framortej/TFG_MySenser-Domoticz/README.md

# TFG_MySenser-Domoticz
Repositorio del TFG "Desarrollo de sistemas domóticos basados en la red MySensor"
