framortej/TFG_MySenser-Domoticz/DOC/(PRESENTACION_V1.2)Desarrollo de sistemas domóticos basados en la red MySensor.pdf

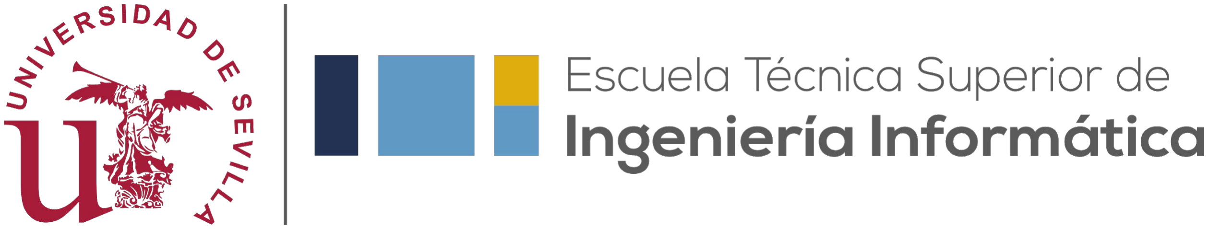
[picture p1: figure]

# Desarrollo de sistemas domóticos basados en la red MySensor

## Alumno: Francisco Moreno Tejeda Tutor: Manuel Jesús Bellido Díaz

# Índice

## ➔ Introducción

## ➔ Planificación

## ➔ Recursos

## ➔ P0 Shield para Raspberry Pi

## ➔ P1 - P2 Gestión eléctrica

## ➔ P3 Control lumínico de tiras LEDs

## ➔ P4 Estación Meteorológica

## ➔ Conclusión y futuro del proyecto

## ➔ Preguntas

# Introducción

### - ¿Qué es la domótica?

- Automatización del hogar
- Llevar el control al mundo digital
- Gestión desde un mismo dispositivo
- Aumentar la seguridad
- Ahorro energético

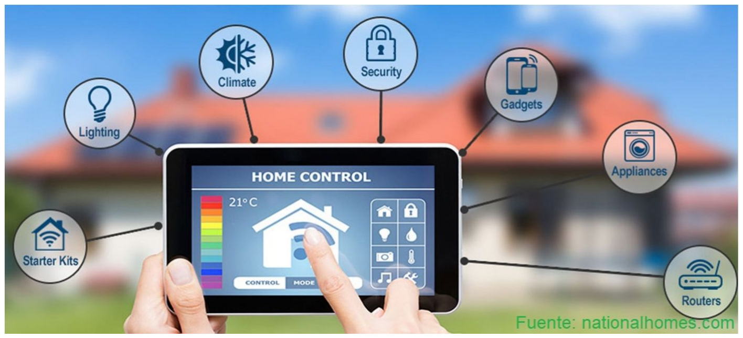
[picture p2: figure]

# Introducción

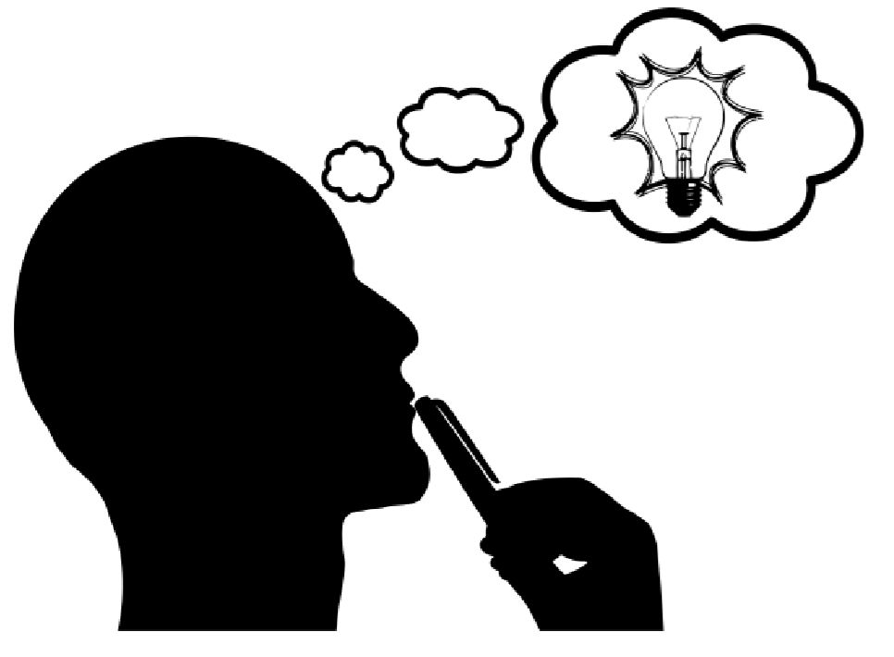
[picture p3: figure]

### - Motivación del TFG

- Ahorro de costes
- Gestión autónoma
- Personalización a medida
- Posibilidades educativas
- Gusto por el tema

# Planificación

### - Objetivos

- Gestionar la energía del hogar
- Gestionar el brillo de una tira led
- Adquisición de datos ambientales

### - Requisitos

- Se debe controlar un enchufe
- Se debe controlar un lámpara
- Se debe gestionar una tira led
- Se debe adquirir datos medioambientales, para, si procede, gestionar los requisitos anteriores.

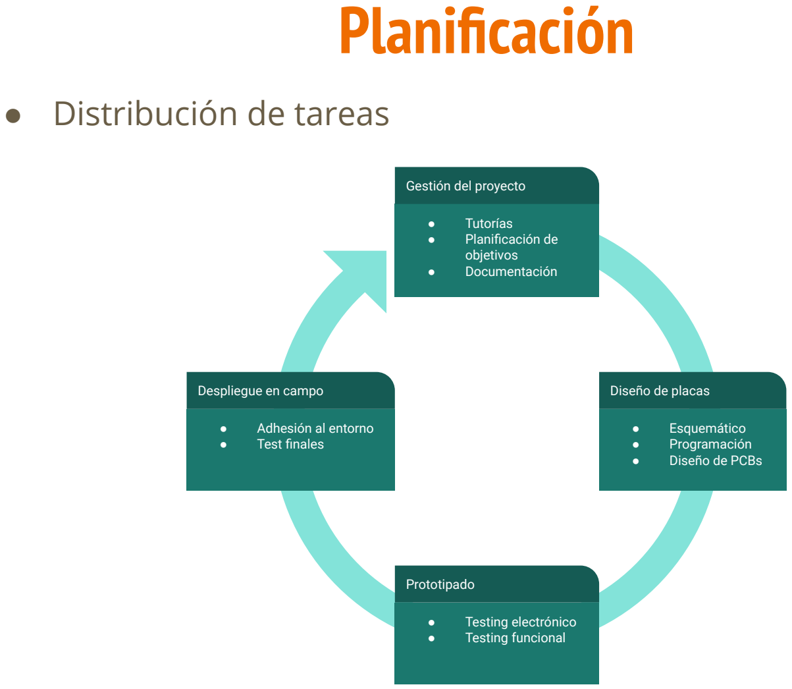
[picture p4: figure]
Planificación; ● Distribución de tareas; ● Esquemático ● Programación ● Diseño de PCBs; Diseño de placas; ● Tutorías ● Planificación de objetivos ● Documentación; Gestión del proyecto; ● Adhesión al entorno ● Test finales; Despliegue en campo; ● Testing electrónico ● Testing funcional; Prototipado

# Planificación

### - Costes

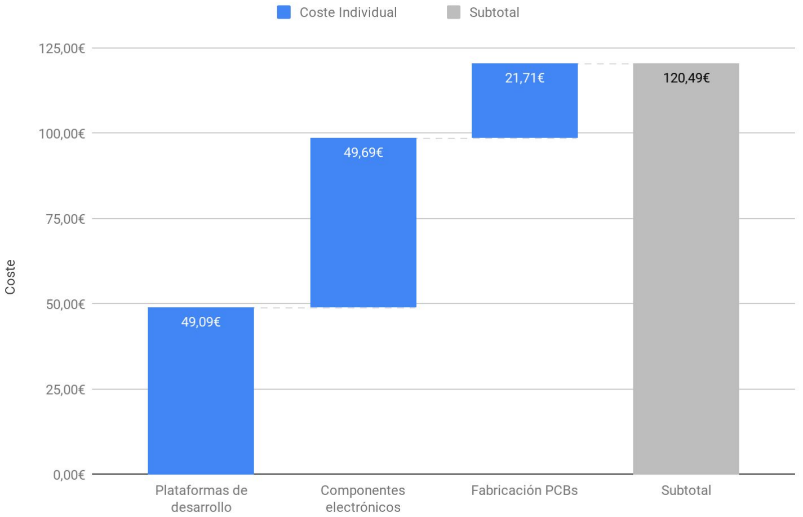
[picture p5: figure]

# Recursos

### - MySensors

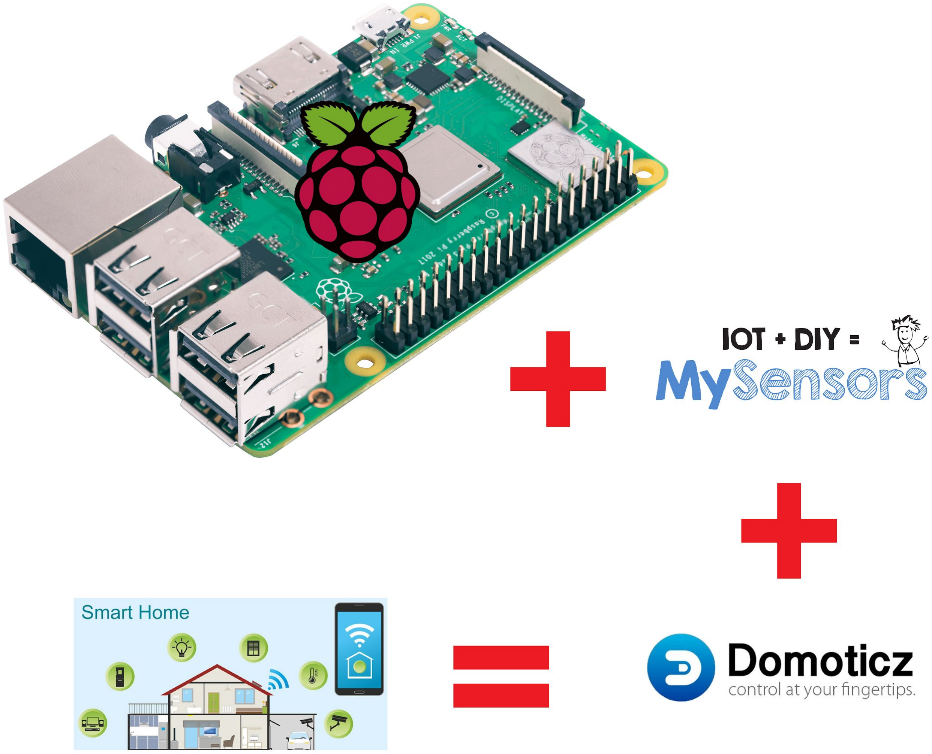
[picture p6: figure]

- Código abierto
- Simplicidad de programación
- Comunidad muy extensa
- Compatibilidad con bastantes controladores

### - Domoticz

- Código abierto
- Multiplataforma
- Gestión de usuarios
- Posibilidad de programación
- Altamente Personalizable
- Aplicación en Android

# Recursos

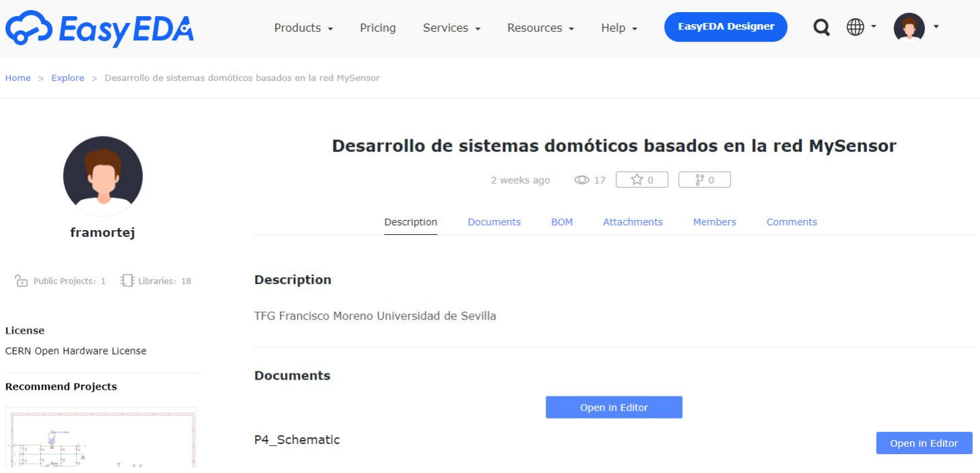
[picture p7: figure]

### - EasyEDA

- Editor gratuito
- Gran comunidad
- Miles de librerías
- Proyectos públicos
- Multiplataforma

### - Arduino IDE

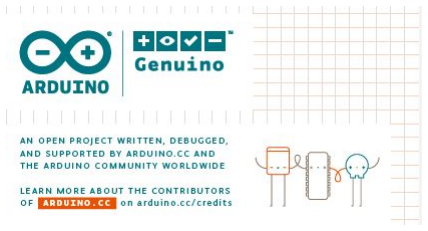
[picture p8: figure]

- Código abierto
- Simplicidad de programación
- Multiplataforma
- Compatibilidad total con las placas
- GitHub
- Plataforma gratuita
- Control de versiones
- Gran comunidad

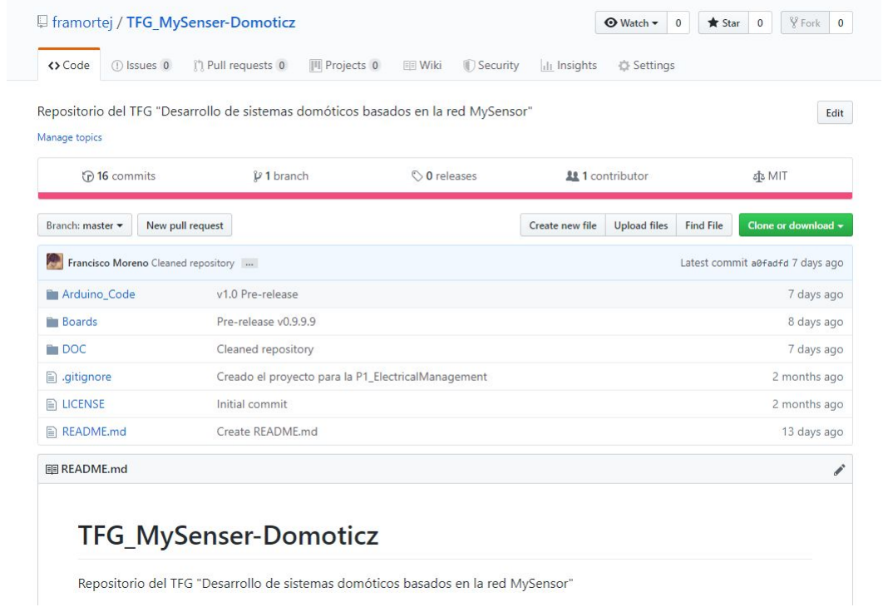
[picture p9: figure]

# P0 Shield para Raspberry Pi

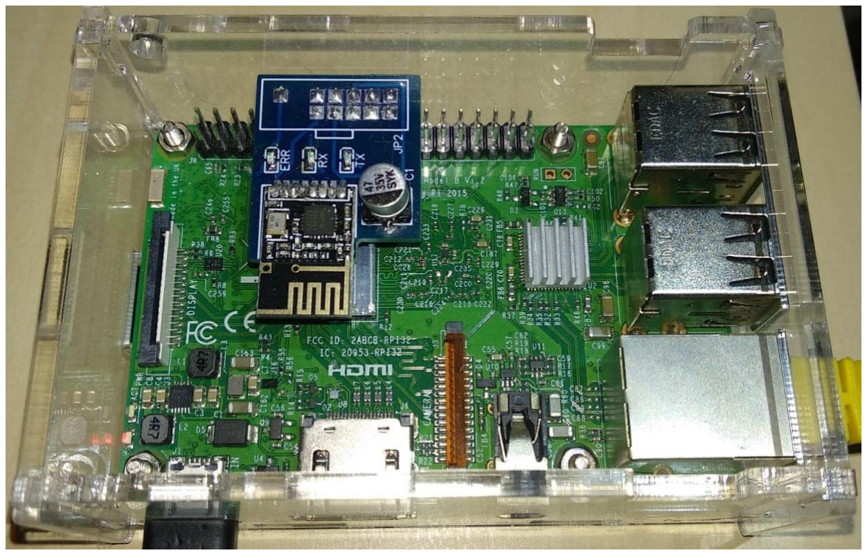
[picture p10: figure]

### - Componentes principales

- nRF24L01+
- 3 LEDs

### - Funcionalidad Principal

- Comunicaciones entre el GW y los nodos
- Indicar el estado del GW
- Mitigar posible errores de comunicación

# P1 - P2 Gestión Eléctrica

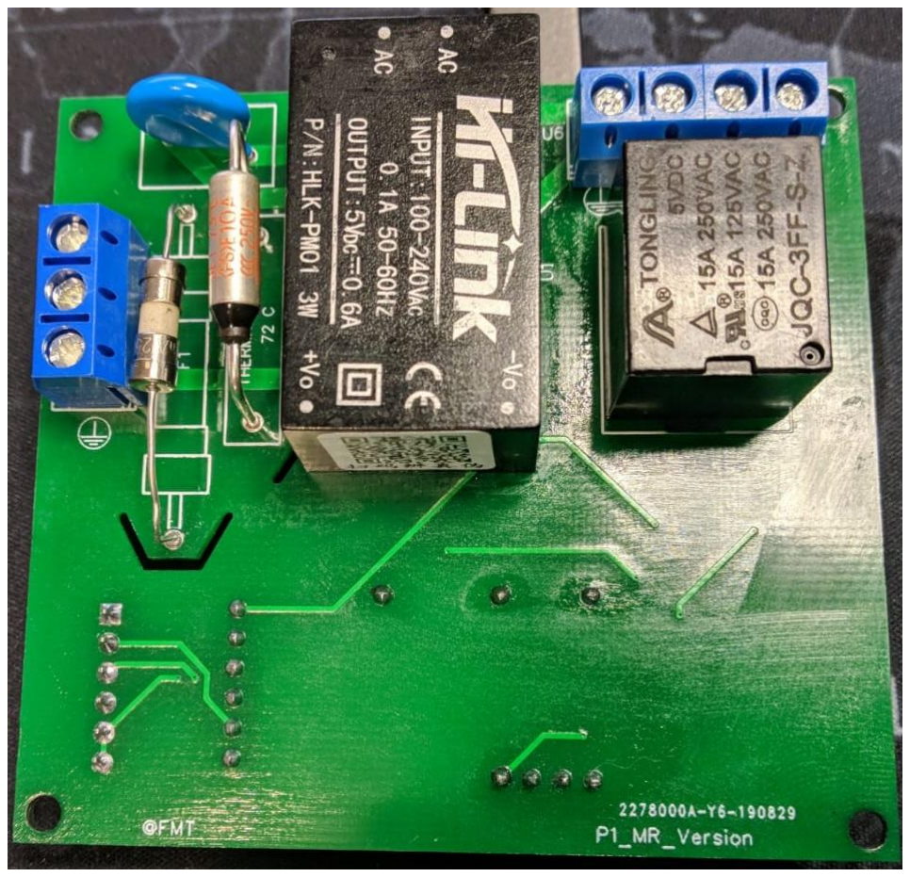
[picture p11: figure]

### - Componentes principales

- nRF24L01+
- Fuente de alimentación 230V-5V
- LED
- Arduino Pro Mini 5V
- Relé
■ Mecánico 15A
■ SSR 2A

### - Funcionalidad Principal

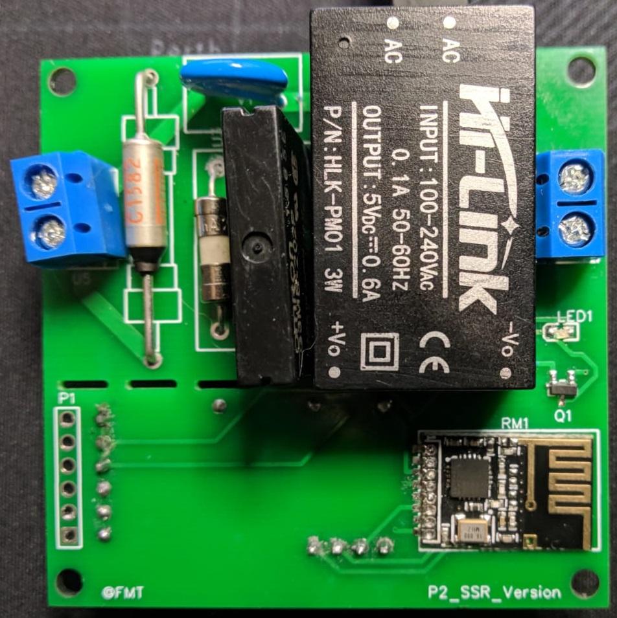
[picture p12: figure]

- Control de la tensión hasta 3450W (15A) ■ Gestión de un enchufe
- Control de la tensión hasta 460W (15A) ■ Gestión de una lámpara

# P3 Control Lumínico USB

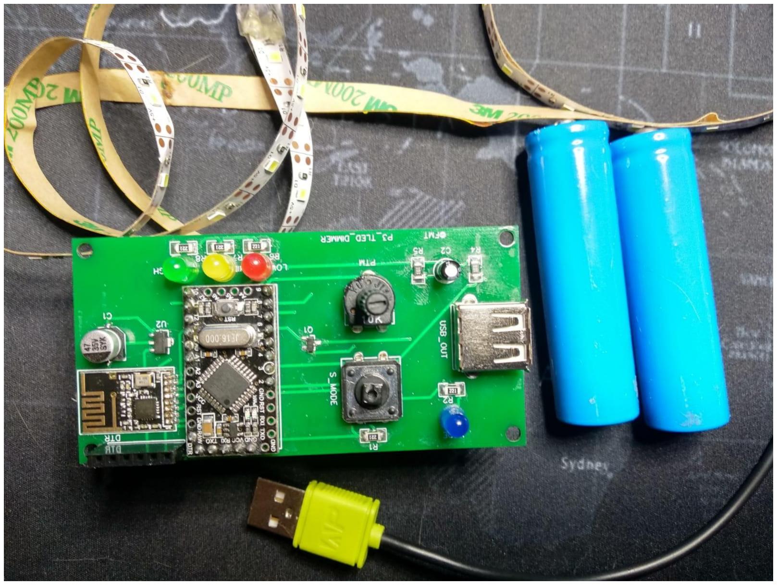
[picture p13: figure]

### - Componentes principales

- nRF24L01+
- Potenciómetro & botón
- 4 LEDs
- Arduino Pro Mini 5V
- 2 Baterías 18650

### - Funcionalidad Principal

- Control del brillo de una tira led de 5V
- Control tanto manual como online

# P4 Estación Meteorológica

### - Componentes principales

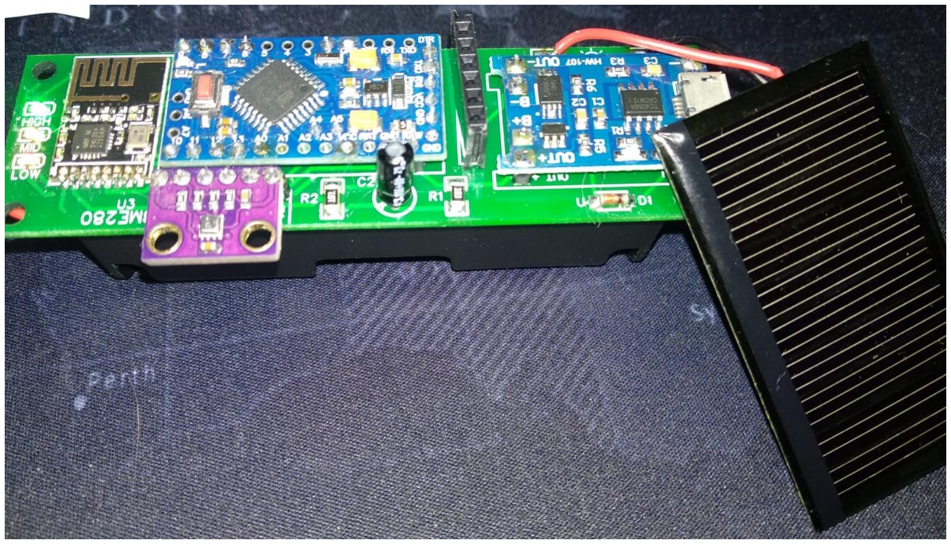
[picture p14: figure]

- nRF24L01+
- 3 LEDs
- Arduino Pro Mini 3.3V
- 1 Baterías 18650
- Sensor BME 280
- Panel solar 5v 30mA
- Gestor de carga TP4056

### - Funcionalidad Principal

- Envío cada 10 m de:
■ Temperatura
■ Humedad
■ Presión Atmosférica

# Conclusión y futuro del proyecto

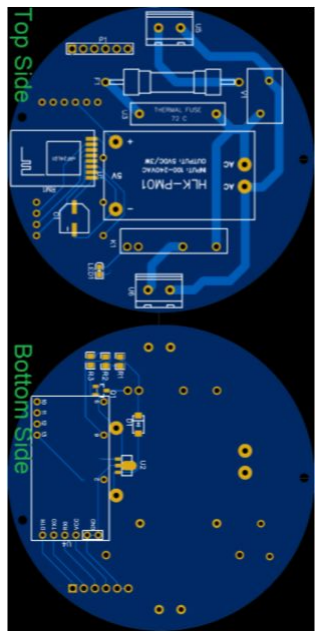
[picture p15: figure]

### - Conclusión - Gestión de las funciones básicas de un hogar - Control por usuario - Entorno altamente escalable - Personalización a medida

### - Proyecto de futuro - Continuar en el Master - Eliminación total de componentes comerciales - Comunicación entre nodos ■ Mando a distancia ■ NFC

# Preguntas

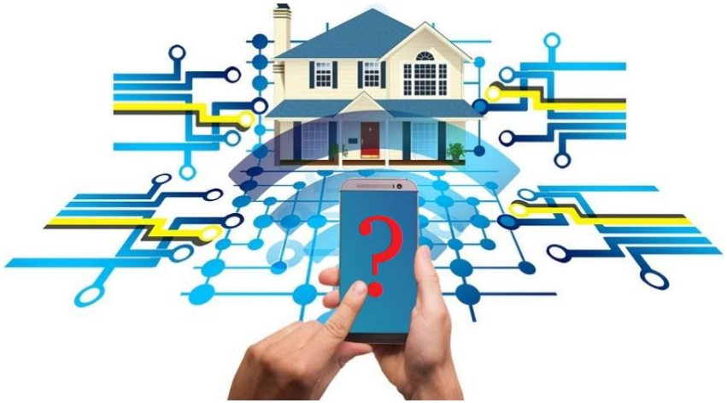
[picture p16: figure]
