framortej/TFG_MySenser-Domoticz/Boards/README.md

All projects are hosted at https://easyeda.com 
The website of the project is:
https://easyeda.com/framortej/desarrollo-de-sistemas-dom-ticos-basados-en-la-red-mysensor
