framortej/TFG_MySenser-Domoticz/Boards/Project_P1_ElectricalManagement_MechanicalRelay/README.txt

            
How to use：

At editor, Click the document icon on the topbar, via "Document" > "Open" > "EasyEDA Source", and select json file, then open it at the editor.
