framortej/TFG_MySenser-Domoticz/(list of files, drawings)

Other design files:
KiCad_Projects/opi_nrf24/opi_nrf24.dsn
KiCad_Projects/rpi_nrf24(ERROR)/rpi_nrf24.dsn
KiCad_Projects/rpi_nrf24/rpi_nrf24.dsn
