framortej/TFG_MySenser-Domoticz/Boards/PCB_HAB_LDH/PCB_HAB_LDH.kicad_pcb

## KiCad design KiCad_Projects/PCB_HAB_LDH/PCB_HAB_LDH.kicad_pcb (2019-07-13, last stored version)

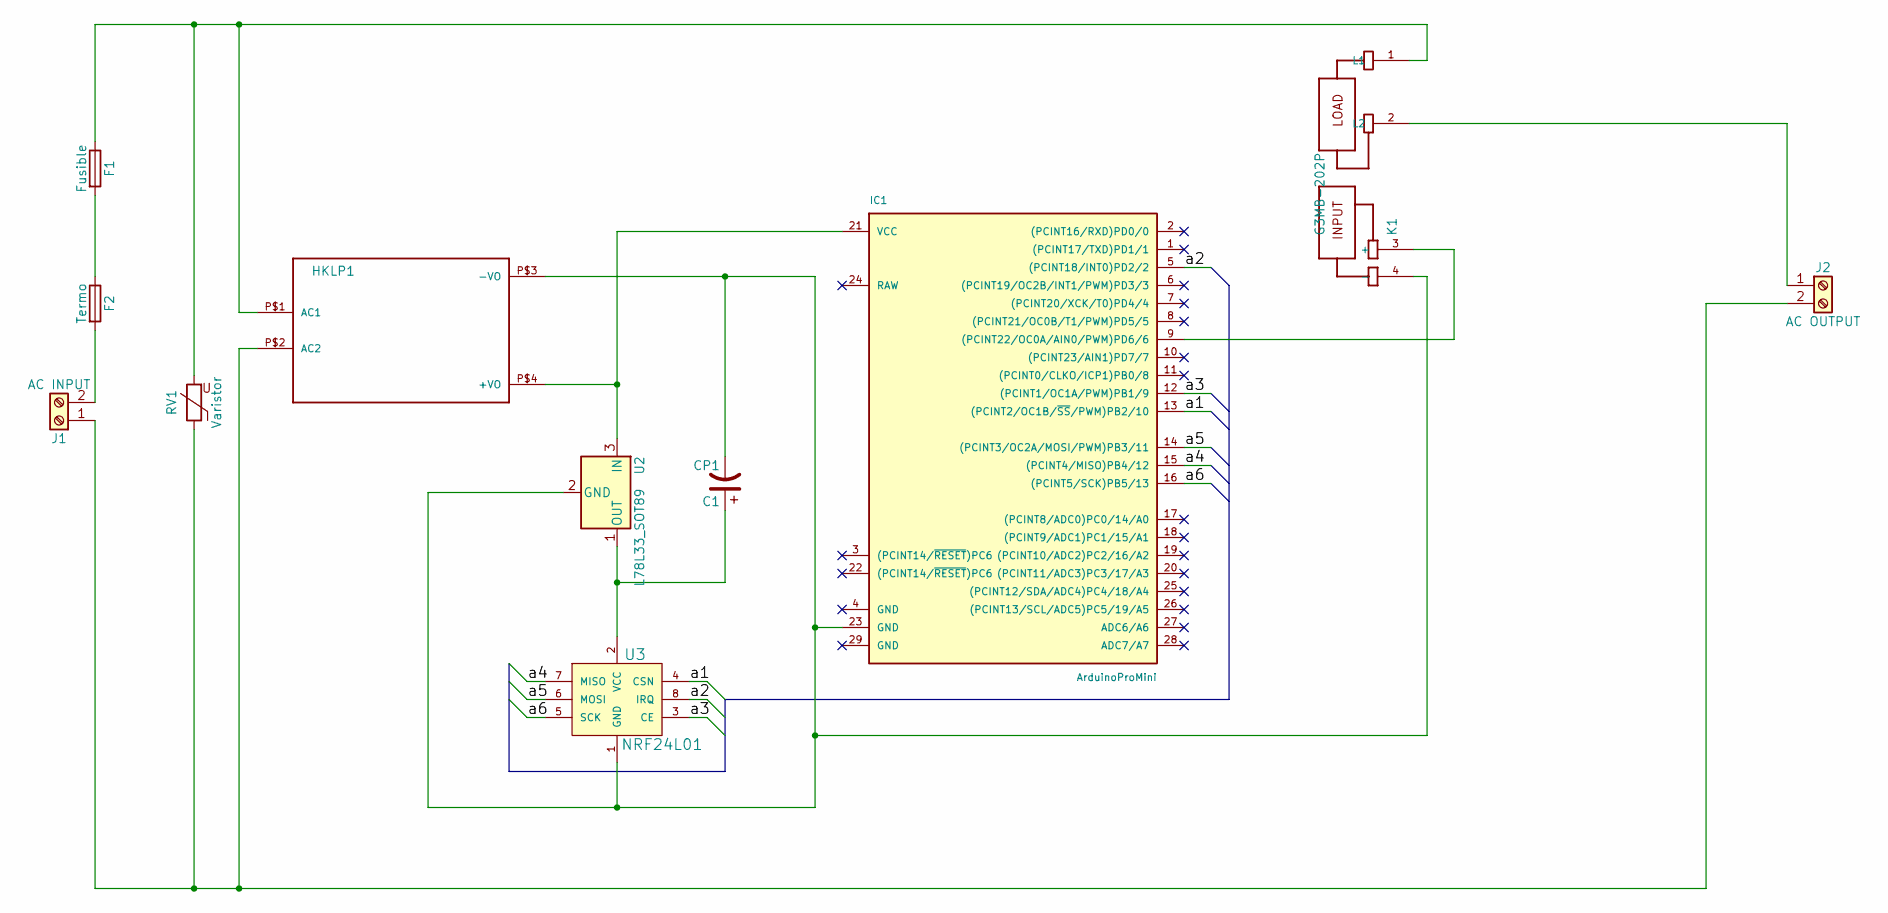
[picture p17: schematic PCB_HAB_LDH.sch]

Parts:
C1: CP1; CP_Radial_D5.0mm_P2.50mm
F1: Fusible; Fuseholder5x20_horiz_SemiClosed_Casing10x25mm
F2: Termo; Fuseholder5x20_horiz_SemiClosed_Casing10x25mm
HKLP1: HKLPM01
IC1: ArduinoProMini; pro_mini_LDH_0.9Pads
J1: AC INPUT; TerminalBlock_bornier-2_P5.08mm
J2: AC OUTPUT; TerminalBlock_bornier-2_P5.08mm
K1: G3MB-202P; RELAY_G3MB-202P
RV1: Varistor; RV_Disc_D7_W3.4_P5
U2: L78L33_SOT89; SOT-89-3
U3: NRF24L01; NRF24L01-SMD

Connections:
/a1: IC1.13 ((PCINT2/OC1B/~SS~/PWM)PB2/10), U3.4 (CSN)
/a2: IC1.5 ((PCINT18/INT0)PD2/2), U3.8 (IRQ)
/a3: IC1.12 ((PCINT1/OC1A/PWM)PB1/9), U3.3 (CE)
/a4: IC1.15 ((PCINT4/MISO)PB4/12), U3.7 (MISO)
/a5: IC1.14 ((PCINT3/OC2A/MOSI/PWM)PB3/11), U3.6 (MOSI)
/a6: IC1.16 ((PCINT5/SCK)PB5/13), U3.5 (SCK)
unnamed: C1.1, U2.1 (OUT), U3.2 (VCC)
unnamed: C1.2, HKLP1.P$3 (-VO), IC1.23 (GND), K1.4 (-), U2.2 (GND), U3.1 (GND)
unnamed: F1.1, HKLP1.P$1 (AC1), K1.1 (L1), RV1.2
unnamed: F1.2, F2.1
unnamed: F2.2, J1.2
unnamed: HKLP1.P$2 (AC2), J1.1, J2.2, RV1.1
unnamed: HKLP1.P$4 (+VO), IC1.21 (VCC), U2.3 (IN)
unnamed: IC1.9 ((PCINT22/OC0A/AIN0/PWM)PD6/6), K1.3 (+)
unnamed: J2.1, K1.2 (L2)

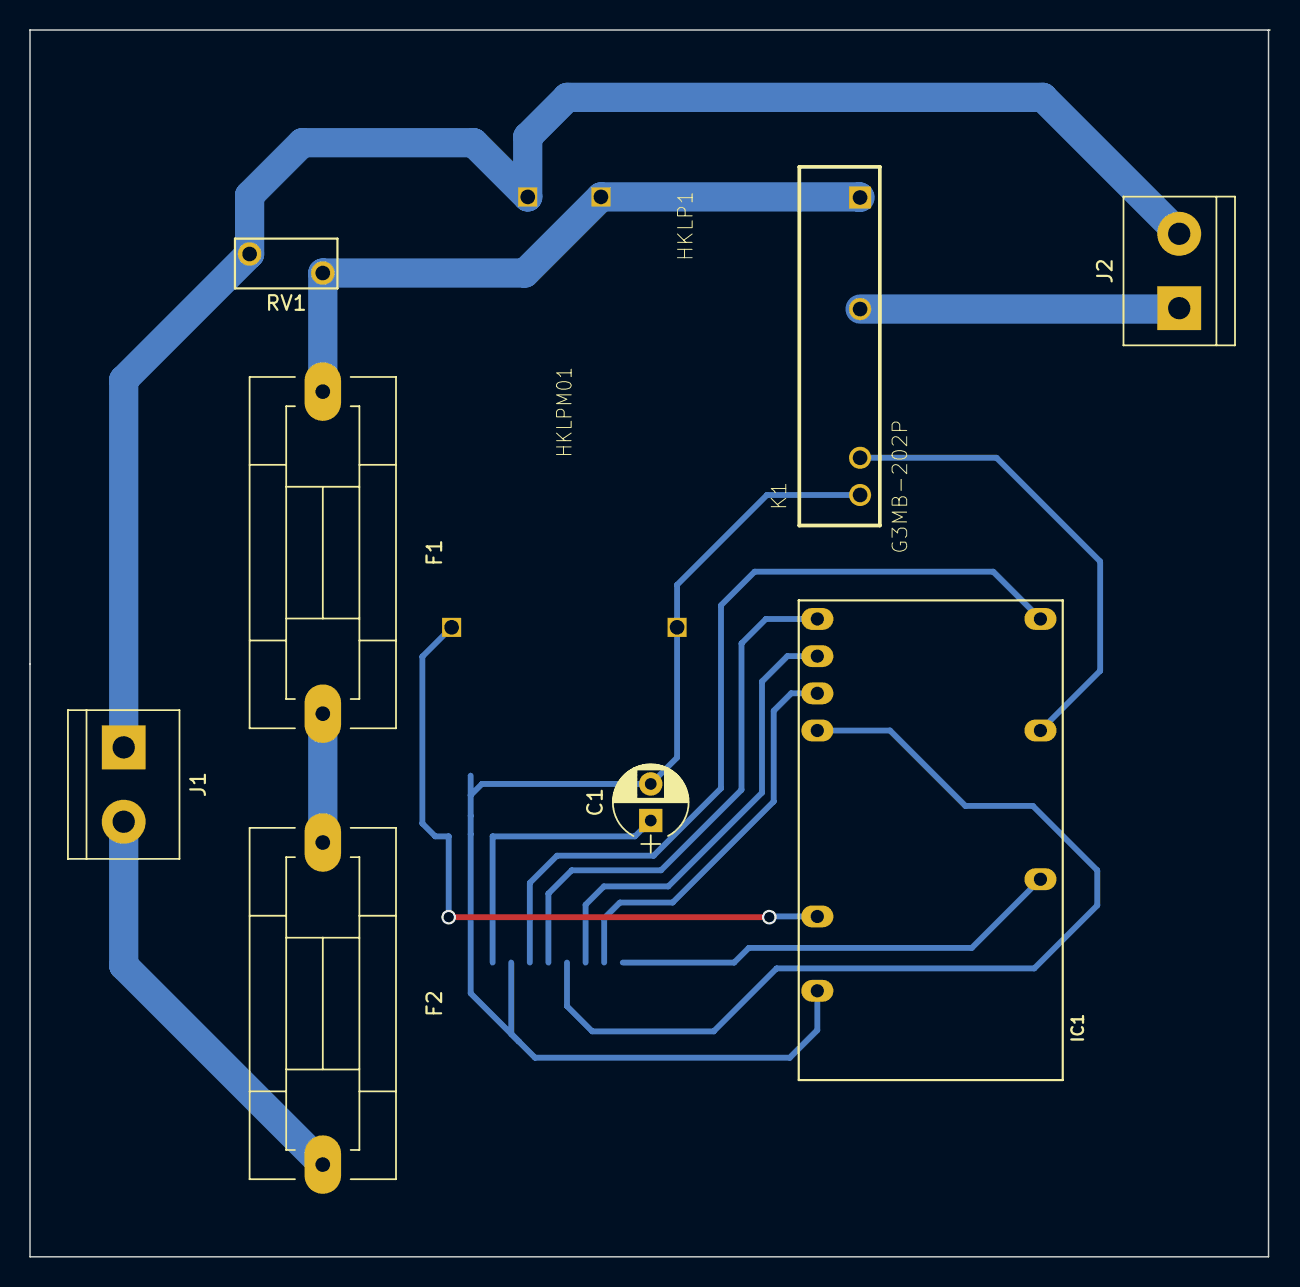
[picture p18: board PCB_HAB_LDH.kicad_pcb from above]

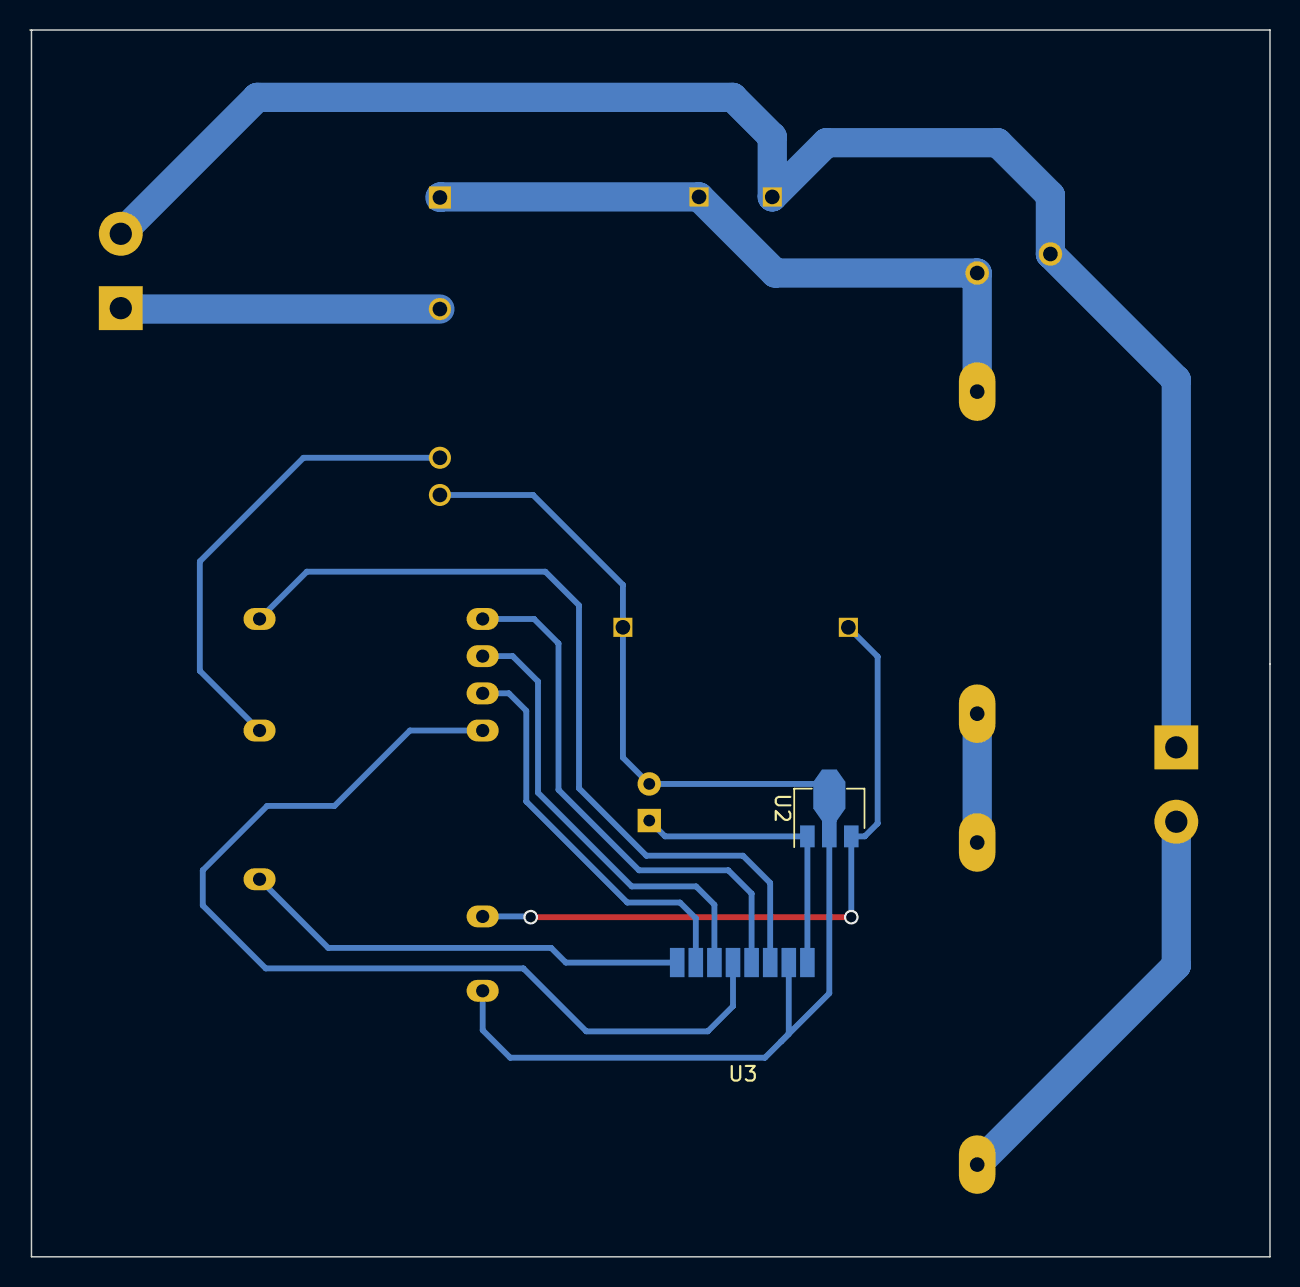
[picture p19: board PCB_HAB_LDH.kicad_pcb from below]

Board: 2 copper layers, 84.7 x 83.8 mm, 11 parts (2 on the bottom side), 15 nets.
