framortej/TFG_MySenser-Domoticz/KiCad_Projects/rpi_nrf24(ERROR)/rpi_nrf24.kicad_pcb

## KiCad design KiCad_Projects/rpi_nrf24(ERROR)/rpi_nrf24.kicad_pcb (2019-07-13, last stored version)

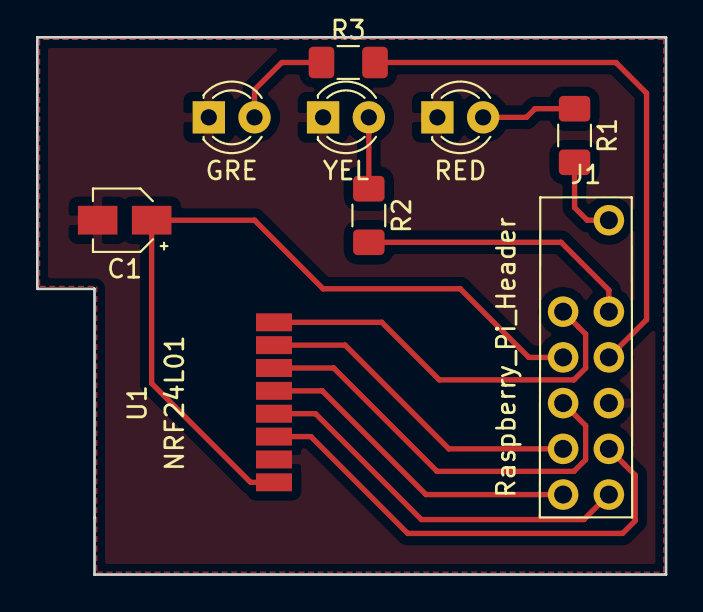
[picture p20: board rpi_nrf24.kicad_pcb from above]

Board: 2 copper layers, 34.9 x 29.8 mm, 9 parts (0 on the bottom side), 14 nets.

Parts:
C1: CP1; CP_Elec_3x5.3
D1: RED; LED_D3.0mm
D2: YEL; LED_D3.0mm
D3: GRE; LED_D3.0mm
J1: Raspberry_Pi_Header; PinHeader_nrf24+leds
R1, R2, R3: R; R_1206_3216Metric_Pad1.42x1.75mm_HandSolder
U1: NRF24L01; NRF24L01-SMD

Connections:
unnamed: C1.1, J1.17, U1.2
unnamed: C1.2, D1.1, D2.1, D3.1, J1.20, U1.1
unnamed: D1.2, R1.1
unnamed: D2.2, R2.1
unnamed: D3.2, R3.1
unnamed: J1.12, R1.2
unnamed: J1.15, U1.8
unnamed: J1.16, R2.2
unnamed: J1.18, R3.2
unnamed: J1.19, U1.6
unnamed: J1.21, U1.7
unnamed: J1.22, U1.3
unnamed: J1.23, U1.5
unnamed: J1.24, U1.4
