framortej/TFG_MySenser-Domoticz/(commit log)

2019-07-14 Creado el proyecto para la P1_ElectricalManagement
    [P1_ElectricalManagement.kicad_pcb, P1_ElectricalManagement.sch, P1_Relee.kicad_pcb, P1_Relee.sch]
2019-07-22 P1, P2 and P3 fisnish. I will Upload it soon!
    [P1_ElectricalManagement.sch, P1_Relee.kicad_pcb, P1_Relee.sch, PCB_HAB_LDH-2019-07-19-18-35-22.sch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]
2019-08-30 Sync PCSERVER
    [PCB_HAB_LDH.csv, PCB_HAB_LDH.kicad_pcb, PCB_HAB_LDH.sch, PCB_HAB_LDH_v1.kicad_pcb, ReleMecanicoTest.kicad_pcb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]
2019-09-10 Pre-release v0.9.9.9
    [P1_ElectricalManagement.kicad_pcb, P1_ElectricalManagement.sch, PCB_HAB_LDH-2019-07-19-18-35-22.sch, PCB_HAB_LDH.csv, PCB_HAB_LDH.kicad_pcb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]
